Thyago-Netto-Baltazar/SISTEMA-DE-CONTROLE-E-MONITORAMENTO-DE-AQUARIO-MARINHO/README.md

# SISTEMA-DE-CONTROLE-E-MONITORAMENTO-DE-AQUARIO-MARINHO
Arquivos Relacionados ao Trabalho de Graduação em Engenharia de Instrumentação, Automação e Robótica da Universidade Federal do ABC, entregue no ano de 2020 pelos alunos Thyago e Renan
